nekowokaburu/GeneCBR101Automation/GeneRev4_PCB/BOM_Gene Rev. 4_2020-09-30_17-34-51.xlsx

ID | Name | Designator | Footprint | Quantity | Manufacturer Part | Manufacturer | Supplier | Supplier Part
1 | 56.2KΩ | R16 | 805 | 1 | 0805W8F5622T5E | UniOhm | LCSC | C17751
2 | 4k or 2k7 | R7 | AXIAL-0.5 | 1 | ?
3 | 240 or 150 w/ 2k7 R7 | R8 | AXIAL-0.5 | 1 | ?
4 | baocheng(Shandong Baocheng Elec) KBP306(60MIL) | D1 | KBP_4P-L14.5-W3.5-P3.81-L | 1 | KBP306 600V 3A 1.1V@3A KPB Bridge Rectifier | Shandong Jingdao Microelectronics | LCSC | C350525
5 | 1k | R2 | AXIAL-0.5 | 1 | MF1/2W-1KΩ±1% T52 | CCO | LCSC | C119418
6 | 210S-1*20P L=11.6MMGold-plated black | P4,P3 | HEADER-2.54-P20 | 2 | 210S-1*20P L=11.6MMGold-plated black | Ckmtw | LCSC | C124374
7 | 8.2nF | C25 | 805 | 1 | 0805B822K500NT | FH | LCSC | C1758
8 | 2N3904_C713605 | Q2 | TO-92-3_L4.9-W3.7-P1.27-L | 1 | 2N3904 | LGE | LCSC | C713605
9 | Screw Terminal | SENSOR_DRUM_POS,SSR_HEATER,RESET_SW,AC_40V_IN,FAN,DRUM | TERMINAL_BLOCK_2P_5 | 6 | PA001-2P | HIWA | LCSC | C128027
10 | Header-Female-2.54_2x4 | ESP-01-S | HDR-TH_8P-P2.54-V-F-R2-C4-S2.54 | 1 | 220S-2*4P H=8.5MM Ytype Gold-plated | Ckmtw | LCSC | C124422
11 | 15uH | L3 | 12*12*8 | 1 | SMDRI127-150MT | SXN | LCSC | C40000
12 | 20pF | C26 | 805 | 1 | 0805CG200J500NT | FH | LCSC | C94472
13 | 22uF | C30,C29 | 1210 | 2 | GRM32ER61E226ME15L | MuRata | LCSC | C97971
14 | TIP120 | Q3,Q4 | TO-220 | 2 | TIP120 | STMicroelectronics | LCSC | C262990
15 | 100nF | C2 | CAP-TH_L10.0-W4.5-P7.50-D1.0 | 1 | 104 250v CBBCapacitor | ReliaPro | LCSC | C21820
16 | 4.7K | R3 | RES-TH_BD2.2-L6.5-P10.50-D0.6 | 1 | MFR0W4F4701A50 | UniOhm | LCSC | C57204
17 | LM350T/NOPB | U2 | TO-220-3_L10.0-W4.5-P2.54-T | 1 | LM350T/NOPB | TI | LCSC | C19876
18 | 40V 3A 550mV@3A Schottky | D2 | SMA(DO-214AC) | 1 | SS34 | Yenji | LCSC | C142458
19 | TPS54331DDAR | U5 | SOIC-8_EP_150MIL | 1 | TPS54331DDAR | TI | LCSC | C90761
20 | 2685Y-106CNG1SNA01 | PROGRAMMER,MAX31855 | HDR-TH_6P-P2.54-V | 2 | 2685Y-106CNG1SNA01 | 华宇创 | LCSC | C350307
21 | 2200uF | C6 | CAP-TH_BD22.0-P10.00-D1.4-FD | 1 | UVY2A222MRD | Nichicon | LCSC | C433206
22 | 732 - MUST BE 3k2!!!! | R18 | 805 | 1 | 0805W8F7320T5E | UniOhm | LCSC | C37998
23 | 2K | R1 | RES-TH_BD2.3-L6.5-P10.50-D0.5 | 1 | - | Chian Chia Elec | LCSC | C119330
24 | 1uF | C1 | CAP-TH_BD4.5-P2.50-D1.0-FD | 1 | TAP105M035SRW | AVX | LCSC | C444778
25 | 4.7uF | C23,C24 | 1210 | 2 | GCM32DR71E475KA55L | MuRata | LCSC | C85869
26 | 1nF | C27 | 805 | 1 | 0805B102K500NT | FH | LCSC | C46553
27 | 10.2KΩ | R17 | 805 | 1 | RTT051022FTP | RALEC | LCSC | C103911
28 | 100nF | C28 | 805 | 1 | 0805B104K500NT | FH | LCSC | C38141
 | 100nF |  | Through Hole P=10mm |  | 100 V through hole |  | LCSC | C83130
 | 100nF |  | 805 |  |  |  |  | C651000
 | 10uF |  | 1206 |  | 10uF ±10% 50V X5R Ceramic |  |  | C77092
 | 15uH |  | smd 10x10 |  | 15uH ±20% 3.9A 41mOhm |  |  | C253610
 | 2.8kOhm±1% |  | 805 |  | 0.125W±100ppm/°C |  |  | C17534
 | 6.81kOhm |  | 805 |  | 6.81kOhm±1% 0.125W±100üüm/°C |  |  | C17771
 | 100kOhm |  | 805 |  | 100Ohm ±1% 0.125W |  |  | C328379
 | 22uF ±20% |  | 805 |  | 22uF ±20% 6.3V X5R multilayer ceramic |  |  | C5674
 | 10uF |  | 805 |  | 10uF ±10% 25V X5R multilayer ceramic |  |  | C329933
 | 7.15kOhm |  | 805 |  | 7.15kOhm ±1% |  |  | C325868
 | 10nF |  | 1206 |  | 10nF ±10% 2kV X7R multilayer ceramic |  |  | C106020
