nekowokaburu/GeneCBR101Automation/GeneRev4_PCB/Internal_power_supply_ordered_version_01.PNG

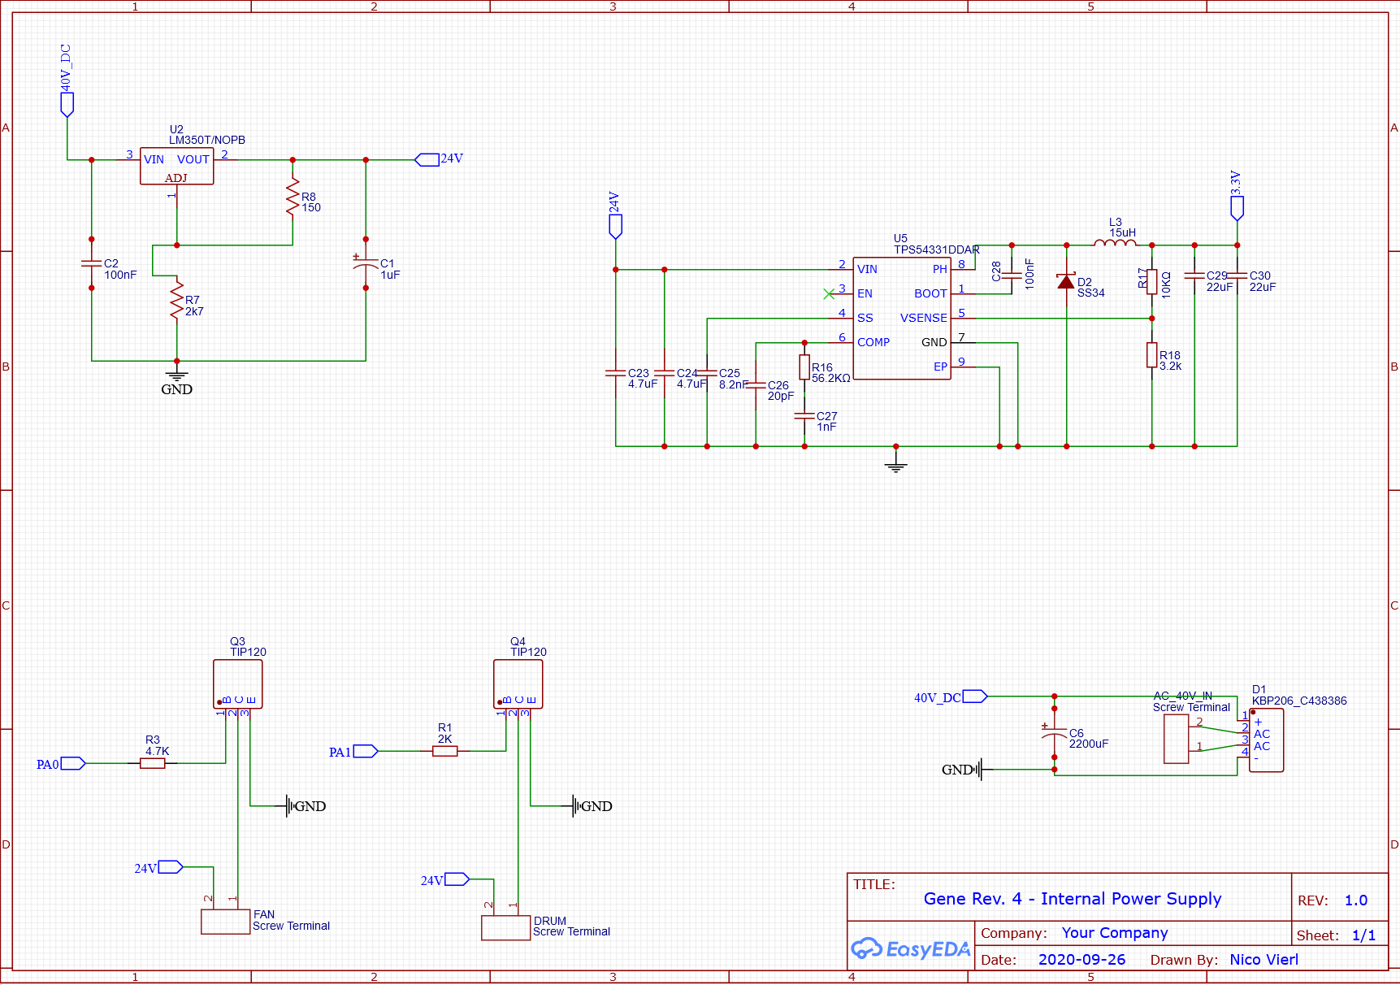
GeneRev4_PCB/Internal_power_supply_ordered_version_01.PNG
