nekowokaburu/GeneCBR101Automation/GeneRev4_PCB/Microcontroller_ordered_version_01.PNG

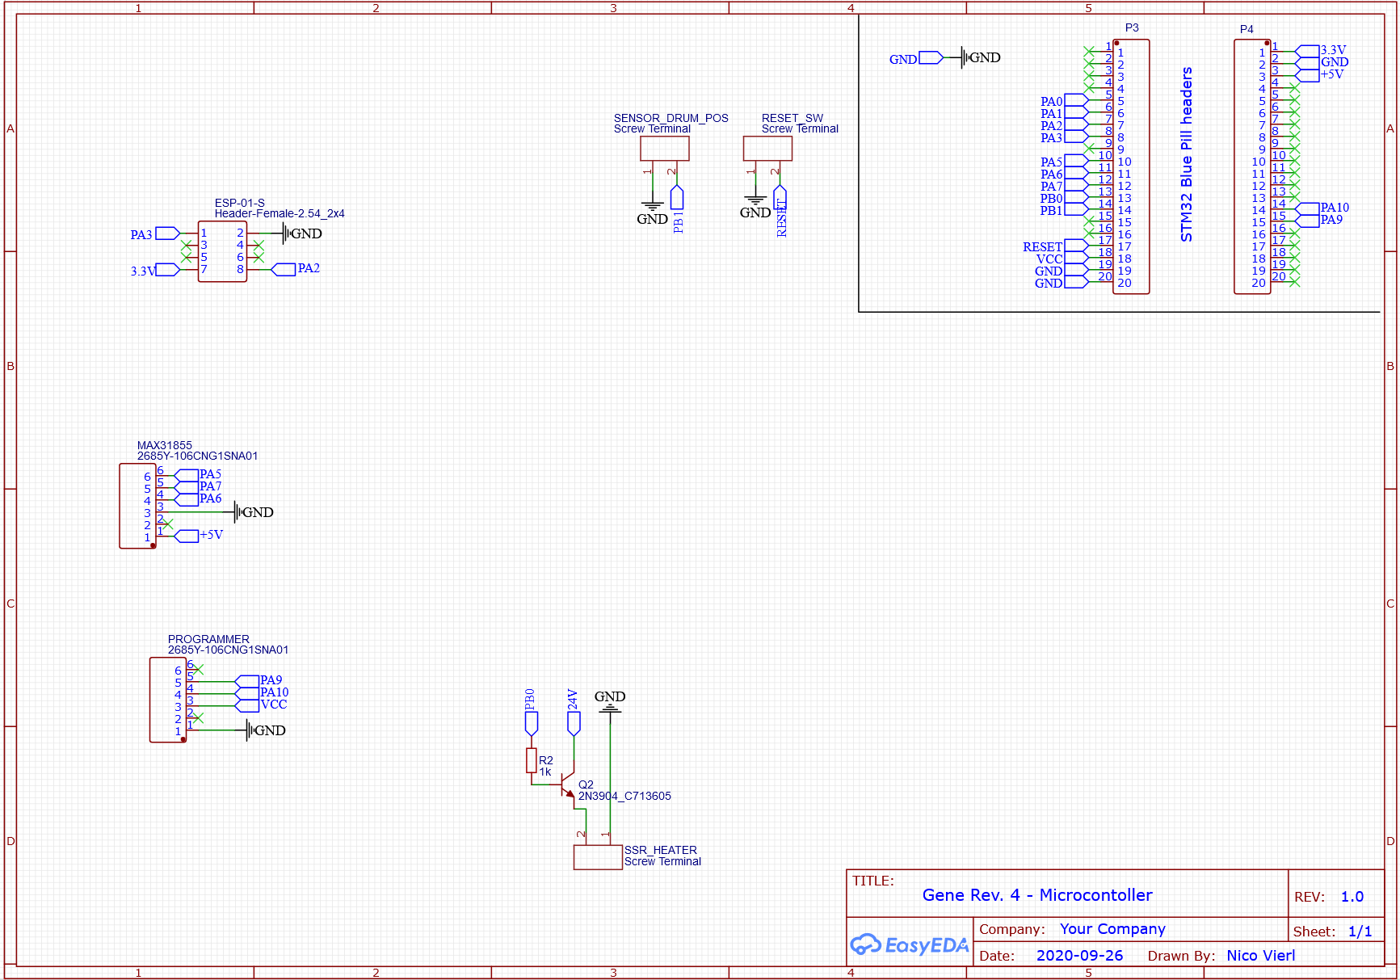
GeneRev4_PCB/Microcontroller_ordered_version_01.PNG
