nekowokaburu/GeneCBR101Automation/GeneRev4_PCB/pcb_ordered_version_01.PNG

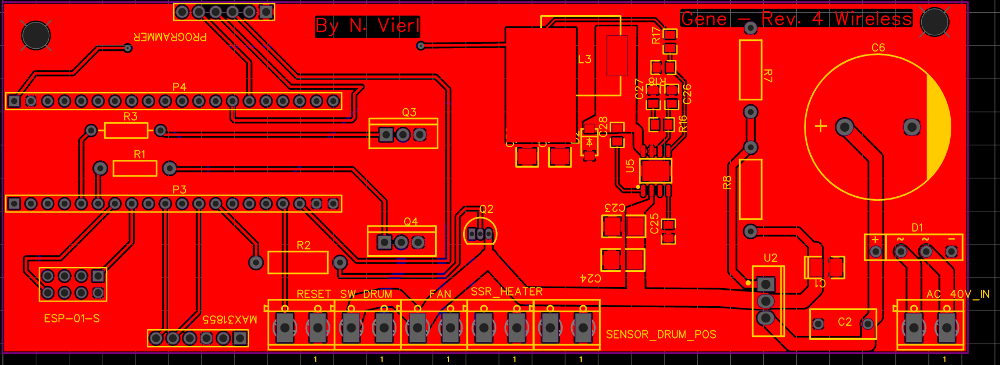
GeneRev4_PCB/pcb_ordered_version_01.PNG
