nekowokaburu/GeneCBR101Automation/GeneRev4_PCB/SSR_control_fix.PNG

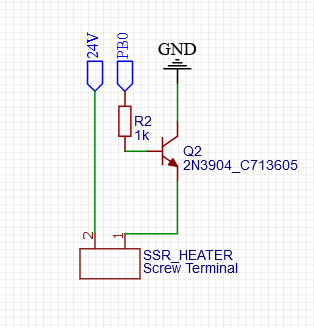
GeneRev4_PCB/SSR_control_fix.PNG
