nekowokaburu/GeneCBR101Automation/(commit log)

2020-12-18 Add Xamarin app projects, arduino project and python Artisan helper
2021-04-19 Add current/first PCB version
    [BOM_Gene Rev. 4_2020-09-30_17-34-51.xlsx]
